aragonxpd154/PFC-circuit/docs/images/psh-card1-3d-top.png

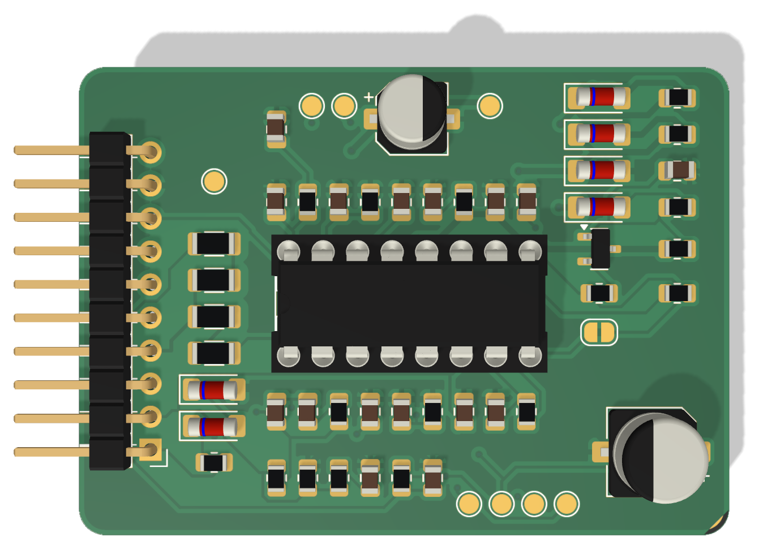
docs/images/psh-card1-3d-top.png
