aragonxpd154/PFC-circuit/docs/images/psh-jig1-bottom.png

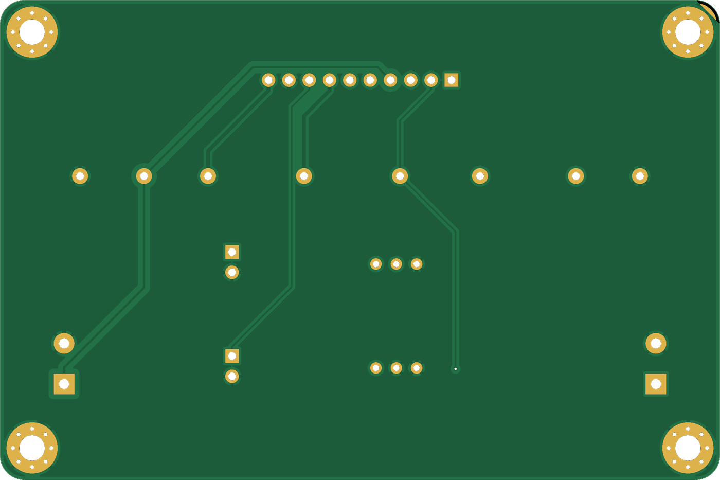
docs/images/psh-jig1-bottom.png
