aragonxpd154/PFC-circuit/docs/images/psh-jig1-layers.png

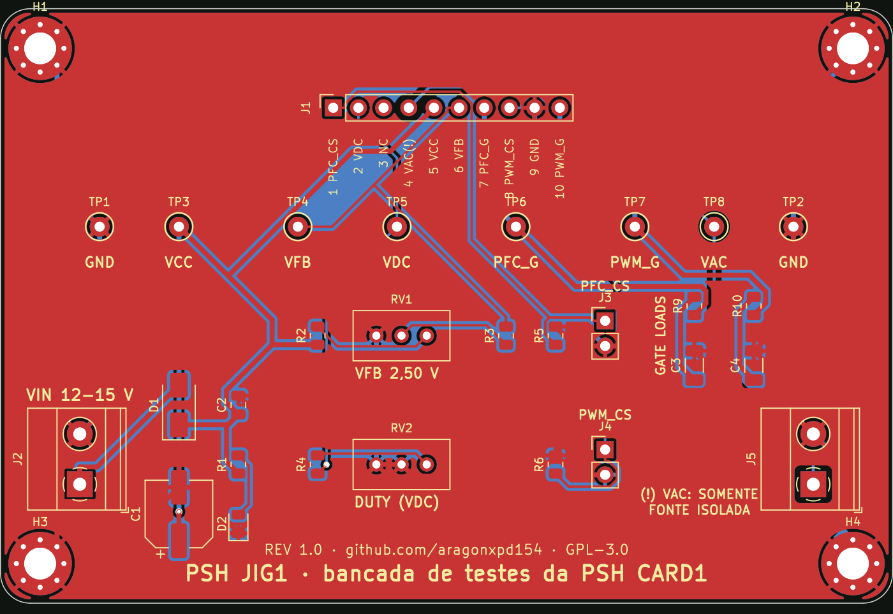
docs/images/psh-jig1-layers.png
