aragonxpd154/PFC-circuit/docs/images/psh-jig1-schematic.png

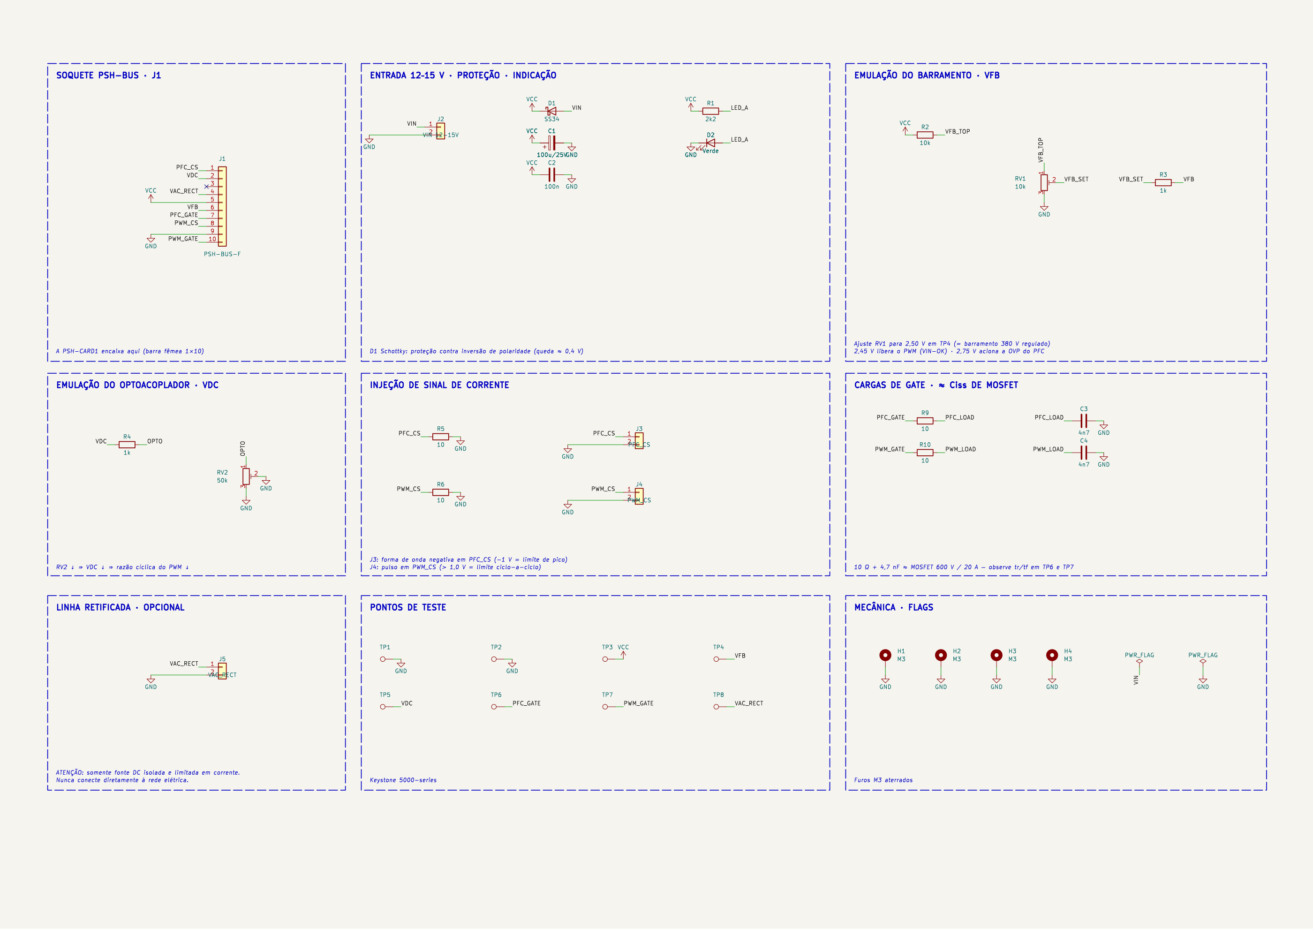
docs/images/psh-jig1-schematic.png
