aragonxpd154/PFC-circuit/mainboard1.jpg

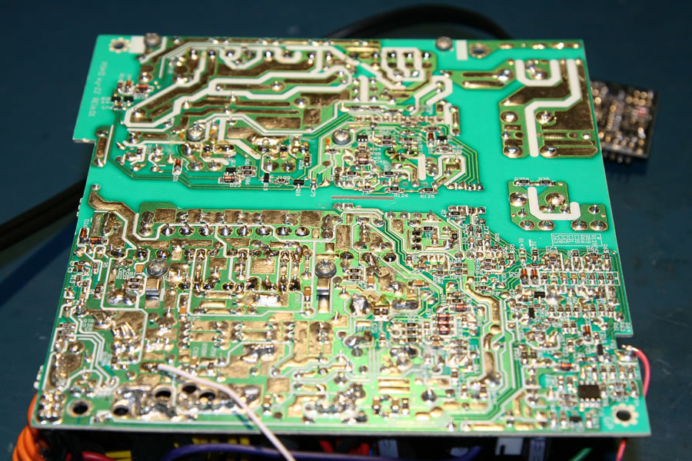
mainboard1.jpg
