aragonxpd154/PFC-circuit/hardware/psh-jig1/fab/psh-jig1-bom.csv

Item | Qtd | Referências | Valor | Footprint | Descrição | MPN | Nota
1 | 1 | D1 | SS34 | D_SMA | Schottky 3 A 40 V — proteção contra inversão | LL4148
2 | 1 | D2 | Verde | LED_0805_2012Metric | LED indicador de alimentação
3 | 4 | R5 R6 R9 R10 | 10 | R_0805_2012Metric | Resistor SMD 0805 1 %
4 | 1 | R2 | 10k | R_0805_2012Metric | Resistor SMD 0805 1 %
5 | 2 | R3 R4 | 1k | R_0805_2012Metric | Resistor SMD 0805 1 %
6 | 1 | R1 | 2k2 | R_0805_2012Metric | Resistor SMD 0805 1 %
7 | 1 | RV1 | 10k | Potentiometer_Bourns_3296W_Vertical | Trimpot multivoltas — ajuste de VFB (2,50 V nominal)
8 | 1 | RV2 | 50k | Potentiometer_Bourns_3296W_Vertical | Trimpot como reostato — emula o transistor do opto
9 | 1 | C2 | 100n | C_0805_2012Metric | Capacitor cerâmico SMD 0805 X7R
10 | 2 | C3 C4 | 4n7 | C_1206_3216Metric | Capacitor cerâmico SMD 1206 X7R
11 | 1 | C1 | 100u/25V | CP_Elec_6.3x7.7 | Capacitor eletrolítico SMD 6.3x7.7 mm
12 | 1 | J3 | PFC_CS | PinHeader_1x02_P2.54mm_Vertical | Injeção de sinal em PFC_CS (gerador de funções)
13 | 1 | J4 | PWM_CS | PinHeader_1x02_P2.54mm_Vertical | Injeção de pulso em PWM_CS (teste do limite de 1 V)
14 | 1 | J5 | VAC_RECT | TerminalBlock_Phoenix_MKDS-1,5-2-5.08_1x02_P5.08mm_Horizontal | Borne VAC_RECT — SOMENTE fonte DC isolada e limitada
15 | 1 | J2 | VIN 12-15V | TerminalBlock_Phoenix_MKDS-1,5-2-5.08_1x02_P5.08mm_Horizontal | Borne 2 vias 5,08 mm — alimentação de bancada
16 | 1 | J1 | PSH-BUS-F | PinSocket_1x10_P2.54mm_Vertical | Barra fêmea 1×10, 2,54 mm — recebe a PSH-CARD1
17 | 8 | TP1 TP2 TP3 TP4 TP5 TP6 TP7 TP8 | — | TestPoint_Keystone_5000-5004_Miniature | Ponto de teste Keystone 5000-series (gancho de ponta de prova)
18 | 4 | H1 H2 H3 H4 | — | MountingHole_3.2mm_M3_Pad_Via | Furo de fixação M3 aterrado
