aragonxpd154/PFC-circuit/hardware/psh-jig1/fab/psh-jig1-parts.csv

Referência | Valor | Footprint | Função | Redes (pino:rede) | Nota
C1 | 100u/25V | CP_Elec_6.3x7.7 | Reservatório de entrada | 1:VCC 2:GND
C2 | 100n | C_0805_2012Metric | Desacoplamento | 1:VCC 2:GND
C3 | 4n7 | C_1206_3216Metric | Ciss emulada (PFC) | 1:PFC_LOAD 2:GND
C4 | 4n7 | C_1206_3216Metric | Ciss emulada (PWM) | 1:PWM_LOAD 2:GND
D1 | SS34 | D_SMA | Schottky 3 A 40 V — proteção contra inversão | 1:VCC 2:VIN
D2 | Verde | LED_0805_2012Metric | LED indicador de alimentação | 1:GND 2:LED_A
H1 | M3 | MountingHole_3.2mm_M3_Pad_Via | Furo de fixação M3 aterrado | 1:GND
H2 | M3 | MountingHole_3.2mm_M3_Pad_Via | Furo de fixação M3 aterrado | 1:GND
H3 | M3 | MountingHole_3.2mm_M3_Pad_Via | Furo de fixação M3 aterrado | 1:GND
H4 | M3 | MountingHole_3.2mm_M3_Pad_Via | Furo de fixação M3 aterrado | 1:GND
J1 | PSH-BUS-F | PinSocket_1x10_P2.54mm_Vertical | Barra fêmea 1×10, 2,54 mm — recebe a PSH-CARD1 | 1:PFC_CS 2:VDC 3:NC 4:VAC_RECT 5:VCC 6:VFB 7:PFC_GATE 8:PWM_CS 9:GND 10:PWM_GATE
J2 | VIN 12-15V | TerminalBlock_Phoenix_MKDS-1,5-2-5.08_1x02_P5.08mm_Horizontal | Borne 2 vias 5,08 mm — alimentação de bancada | 1:VIN 2:GND
J3 | PFC_CS | PinHeader_1x02_P2.54mm_Vertical | Injeção de sinal em PFC_CS (gerador de funções) | 1:PFC_CS 2:GND
J4 | PWM_CS | PinHeader_1x02_P2.54mm_Vertical | Injeção de pulso em PWM_CS (teste do limite de 1 V) | 1:PWM_CS 2:GND
J5 | VAC_RECT | TerminalBlock_Phoenix_MKDS-1,5-2-5.08_1x02_P5.08mm_Horizontal | Borne VAC_RECT — SOMENTE fonte DC isolada e limitada | 1:VAC_RECT 2:GND
R1 | 2k2 | R_0805_2012Metric | Limitador do LED | 1:VCC 2:LED_A
R2 | 10k | R_0805_2012Metric | Topo do divisor de VFB | 1:VCC 2:VFB_TOP
R3 | 1k | R_0805_2012Metric | Série para VFB | 1:VFB_SET 2:VFB
R4 | 1k | R_0805_2012Metric | Série do emulador de opto | 1:VDC 2:OPTO
R5 | 10 | R_0805_2012Metric | Terminação de PFC_CS (0 V sem gerador) | 1:PFC_CS 2:GND
R6 | 10 | R_0805_2012Metric | Terminação de PWM_CS | 1:PWM_CS 2:GND
R9 | 10 | R_0805_2012Metric | Rg interna emulada | 1:PFC_GATE 2:PFC_LOAD
R10 | 10 | R_0805_2012Metric | Rg interna emulada | 1:PWM_GATE 2:PWM_LOAD
RV1 | 10k | Potentiometer_Bourns_3296W_Vertical | Trimpot multivoltas — ajuste de VFB (2,50 V nominal) | 1:VFB_TOP 2:VFB_SET 3:GND
RV2 | 50k | Potentiometer_Bourns_3296W_Vertical | Trimpot como reostato — emula o transistor do opto | 1:OPTO 2:GND 3:GND
TP1 | GND | TestPoint_Keystone_5000-5004_Miniature | Ponto de teste Keystone 5000-series (gancho de ponta de prova) | 1:GND
TP2 | GND | TestPoint_Keystone_5000-5004_Miniature | Ponto de teste Keystone 5000-series (gancho de ponta de prova) | 1:GND
TP3 | VCC | TestPoint_Keystone_5000-5004_Miniature | Ponto de teste Keystone 5000-series (gancho de ponta de prova) | 1:VCC
TP4 | VFB | TestPoint_Keystone_5000-5004_Miniature | Ponto de teste Keystone 5000-series (gancho de ponta de prova) | 1:VFB
TP5 | VDC | TestPoint_Keystone_5000-5004_Miniature | Ponto de teste Keystone 5000-series (gancho de ponta de prova) | 1:VDC
TP6 | PFC_GATE | TestPoint_Keystone_5000-5004_Miniature | Ponto de teste Keystone 5000-series (gancho de ponta de prova) | 1:PFC_GATE
TP7 | PWM_GATE | TestPoint_Keystone_5000-5004_Miniature | Ponto de teste Keystone 5000-series (gancho de ponta de prova) | 1:PWM_GATE
TP8 | VAC_RECT | TestPoint_Keystone_5000-5004_Miniature | Ponto de teste Keystone 5000-series (gancho de ponta de prova) | 1:VAC_RECT
