aragonxpd154/PFC-circuit/docs/3d/psh-jig1.stl

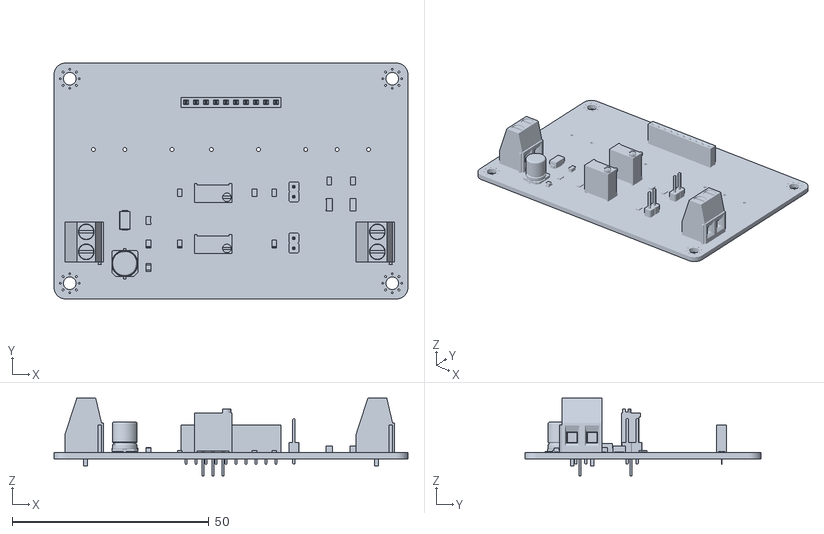
[picture p22: CAD file, 2026-11-02]
docs/3d/psh-jig1.stl
90.0 x 60.0 x 19.8
