aragonxpd154/PFC-circuit/hardware/psh-card1/fab/psh-card1.step

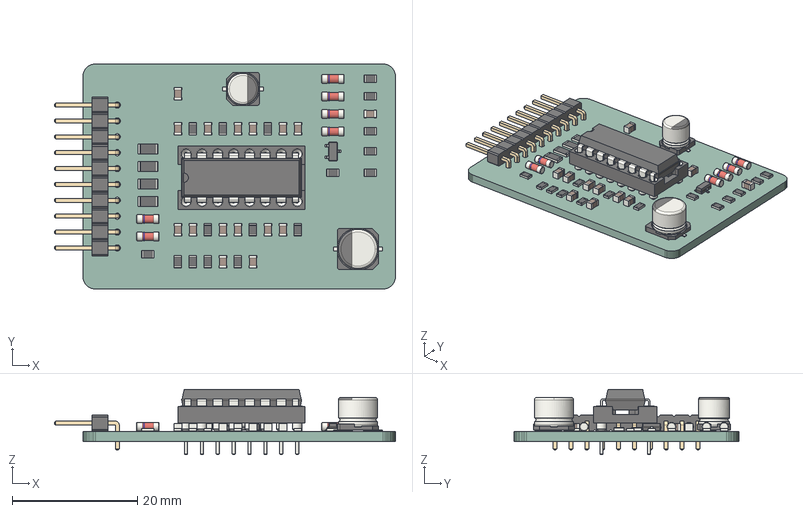
[picture p23: CAD file, 2026-11-02]
hardware/psh-card1/fab/psh-card1.step
54.5 x 36.0 x 10.5 mm
D_MiniMELF_Standard x 6
R_0805_2012Metric x 17
C_0805_2012Metric x 16
CP_Elec_5x54
R_1206_3216Metric x 4
SOT_23
CP_Elec_63x54
PinHeader_1x10_P254mm_Horizontal
DIP_16_W762mm_Socket
DIP-16_W7.62mm
psh-card1 PCB
