aragonxpd154/PFC-circuit/(list of files, cad)

Other CAD files:
hardware/psh-jig1/fab/psh-jig1.step
docs/3d/psh-card1.stl
