aragonxpd154/PFC-circuit/hardware/psh-card1/fab/psh-card1-assembly.pdf

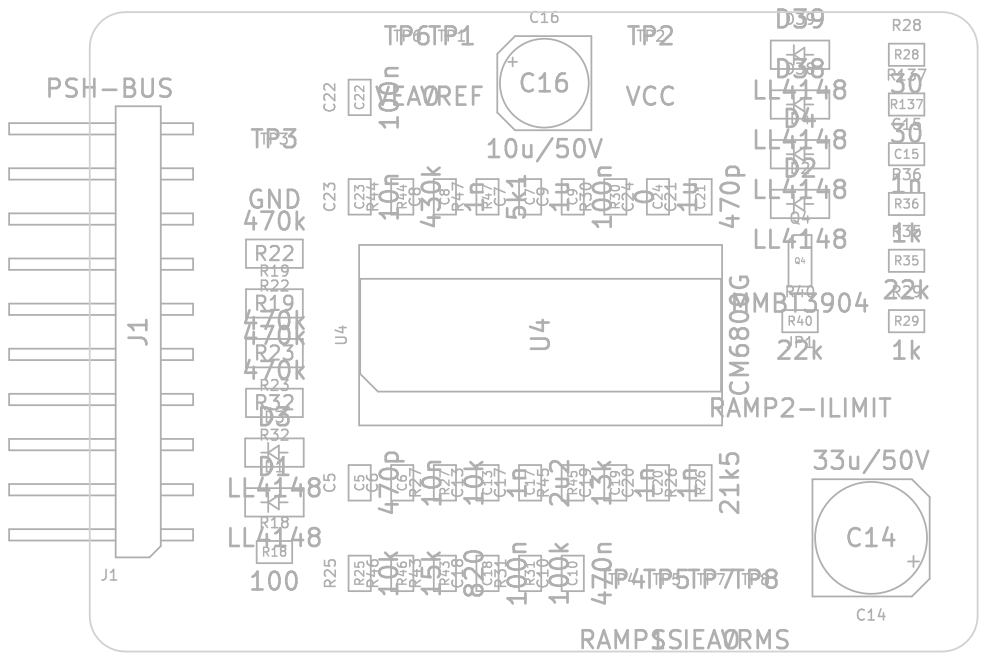
[picture p24: page 1]

Id: 1/1 Title: File: psh-card1.kicad_pcb Sheet:
