aragonxpd154/PFC-circuit/hardware/psh-jig1/fab/psh-jig1-assembly.pdf

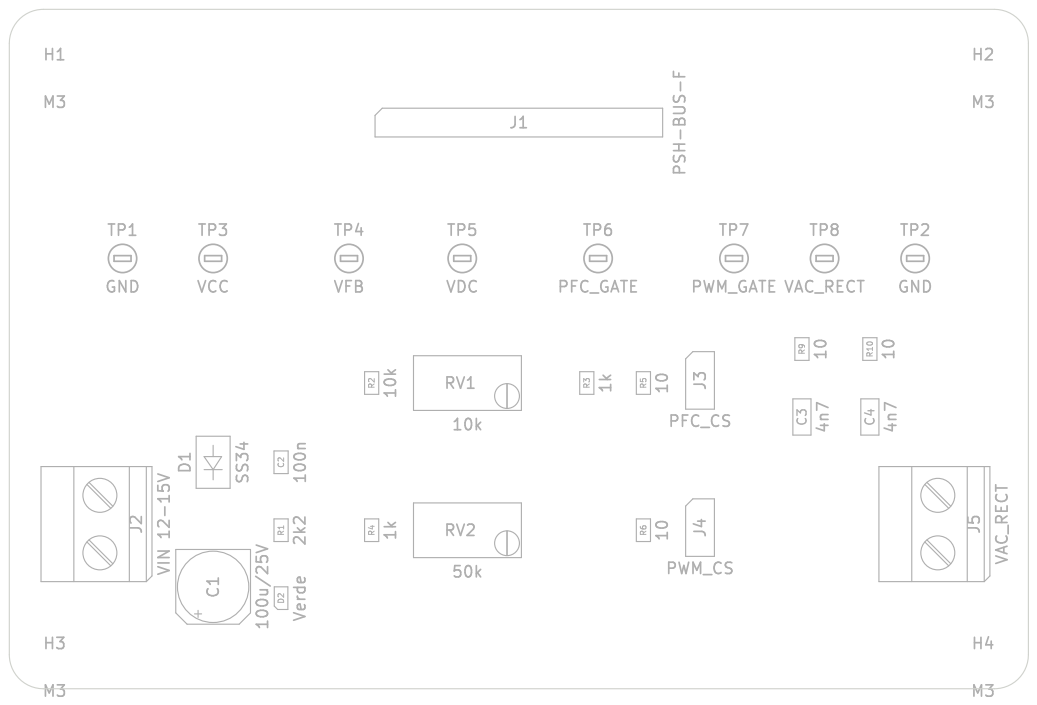
[picture p25: page 1]

Id: 1/1 Title: File: psh-jig1.kicad_pcb Sheet: GND
