aragonxpd154/PFC-circuit/hardware/psh-jig1/fab/psh-jig1-schematic.pdf

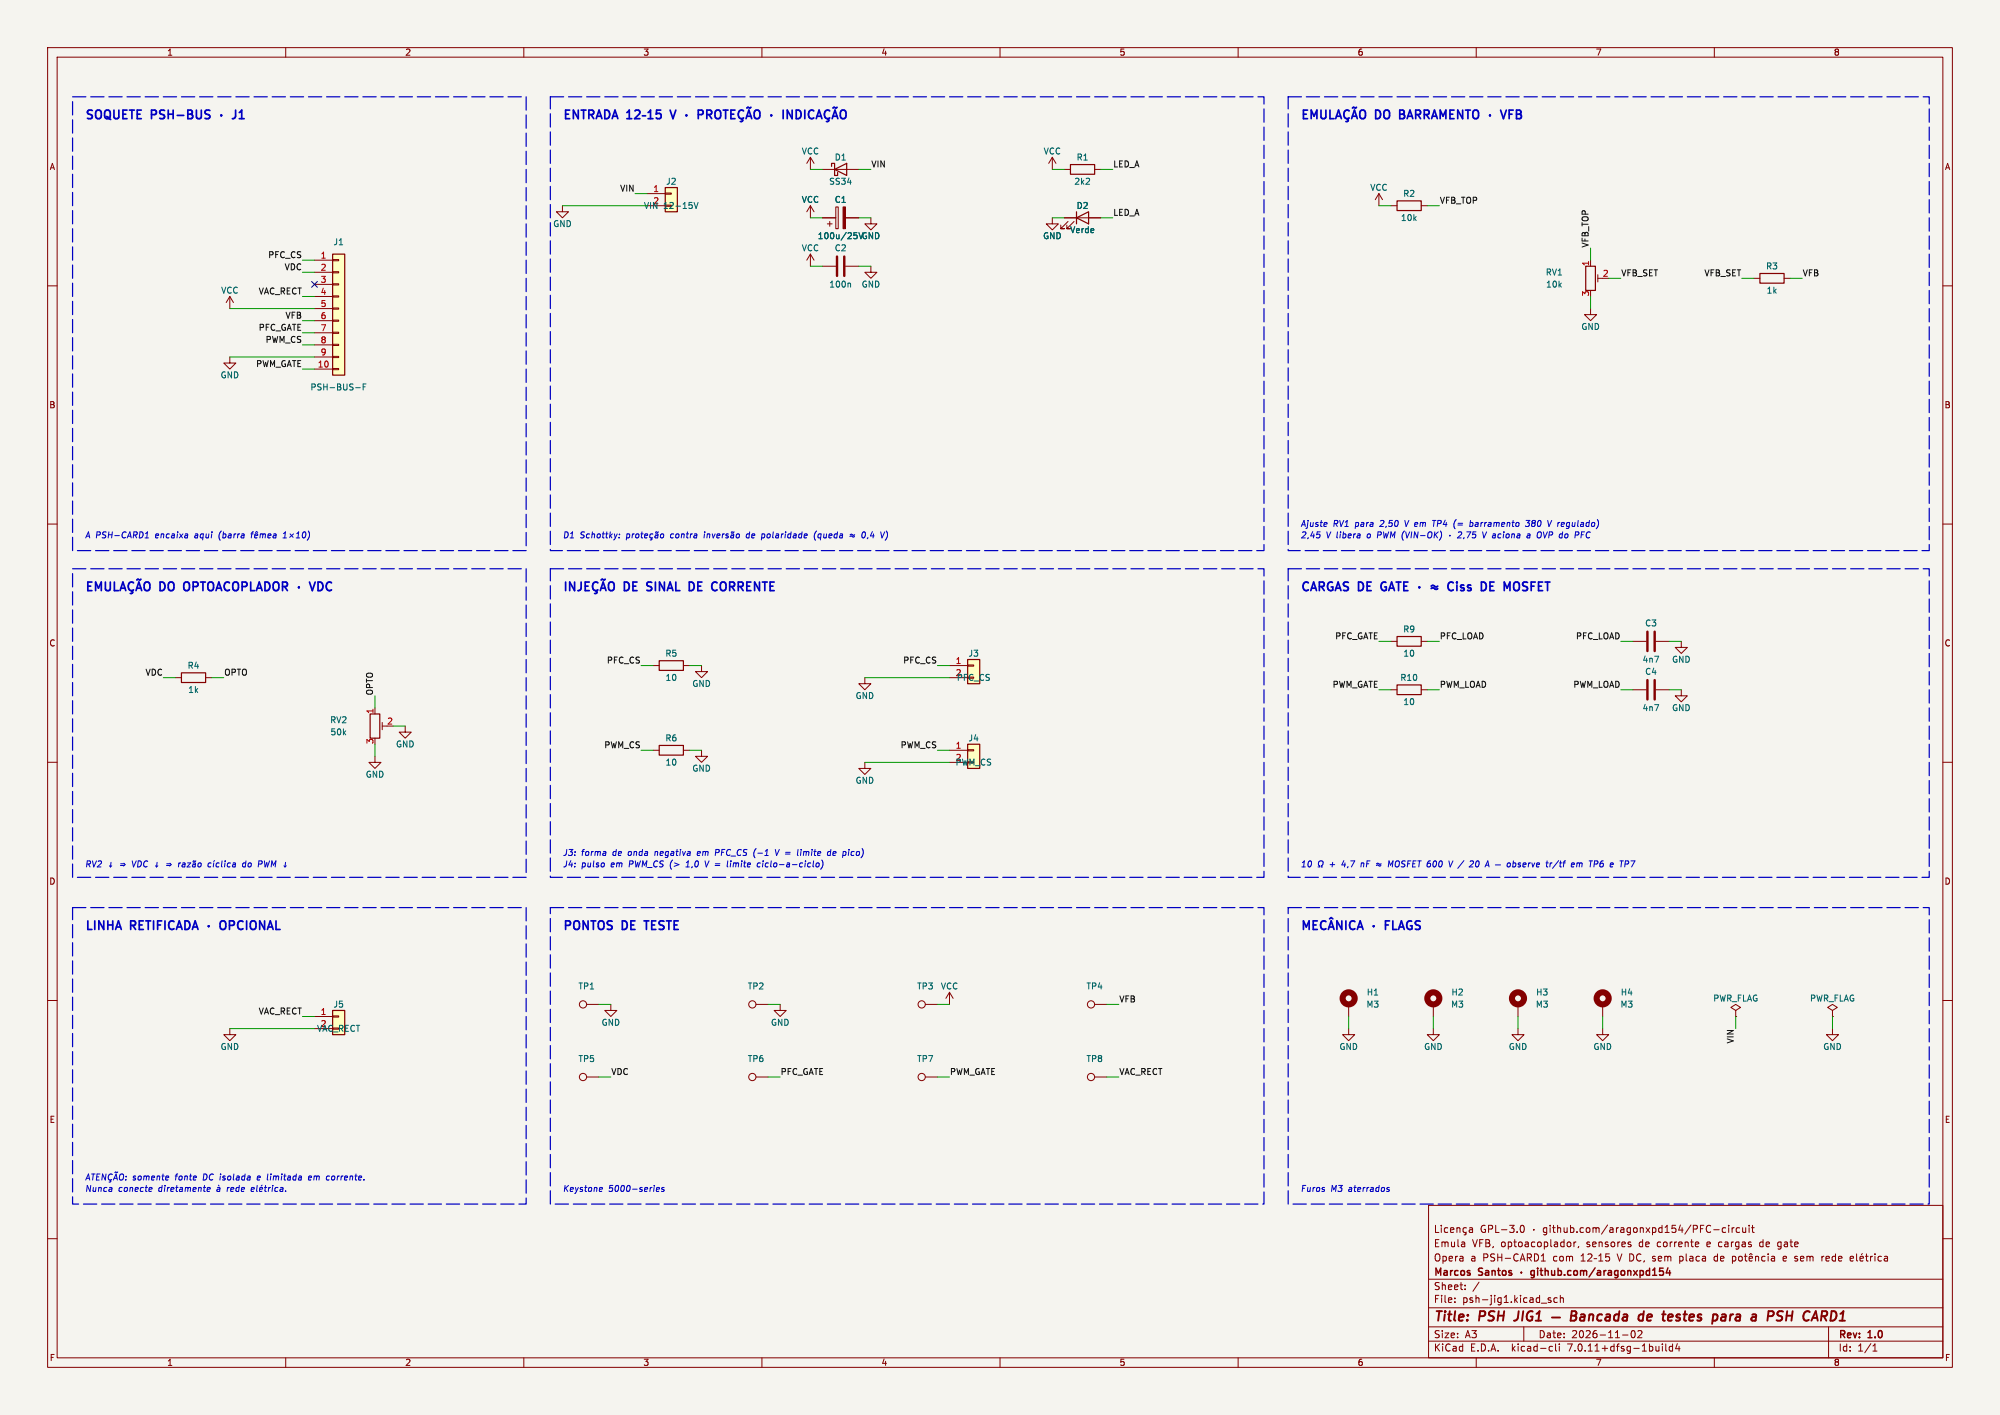
[picture p26: page 1]

ENTRADA þÿ12 15V þÿ·þÿPROTEÇÃO þÿ·þÿINDICAÇÃO

þÿEMULAÇÃO DO BARRAMENTO þÿ·VFB

þÿEMULAÇÃO DO OPTOACOPLADOR þÿ·VDC

þÿINJEÇÃO DE SINAL DE CORRENTE
PWM_CS

CARGAS DE GATE þÿ·þÿ"HCiss DE MOSFET

RV2 þÿ!“þÿ!ÒVDC þÿ!“þÿ!Òþÿrazão þÿcíclica do PWM þÿ!“

Id: 1/1 Title: PSH JIG1 þÿ Bancada de testes para a PSH CARD1
