aragonxpd154/PFC-circuit/hardware/psh-jig1/psh-jig1.kicad_pcb

## KiCad design hardware/psh-jig1/psh-jig1.kicad_pcb (2026-11-02)

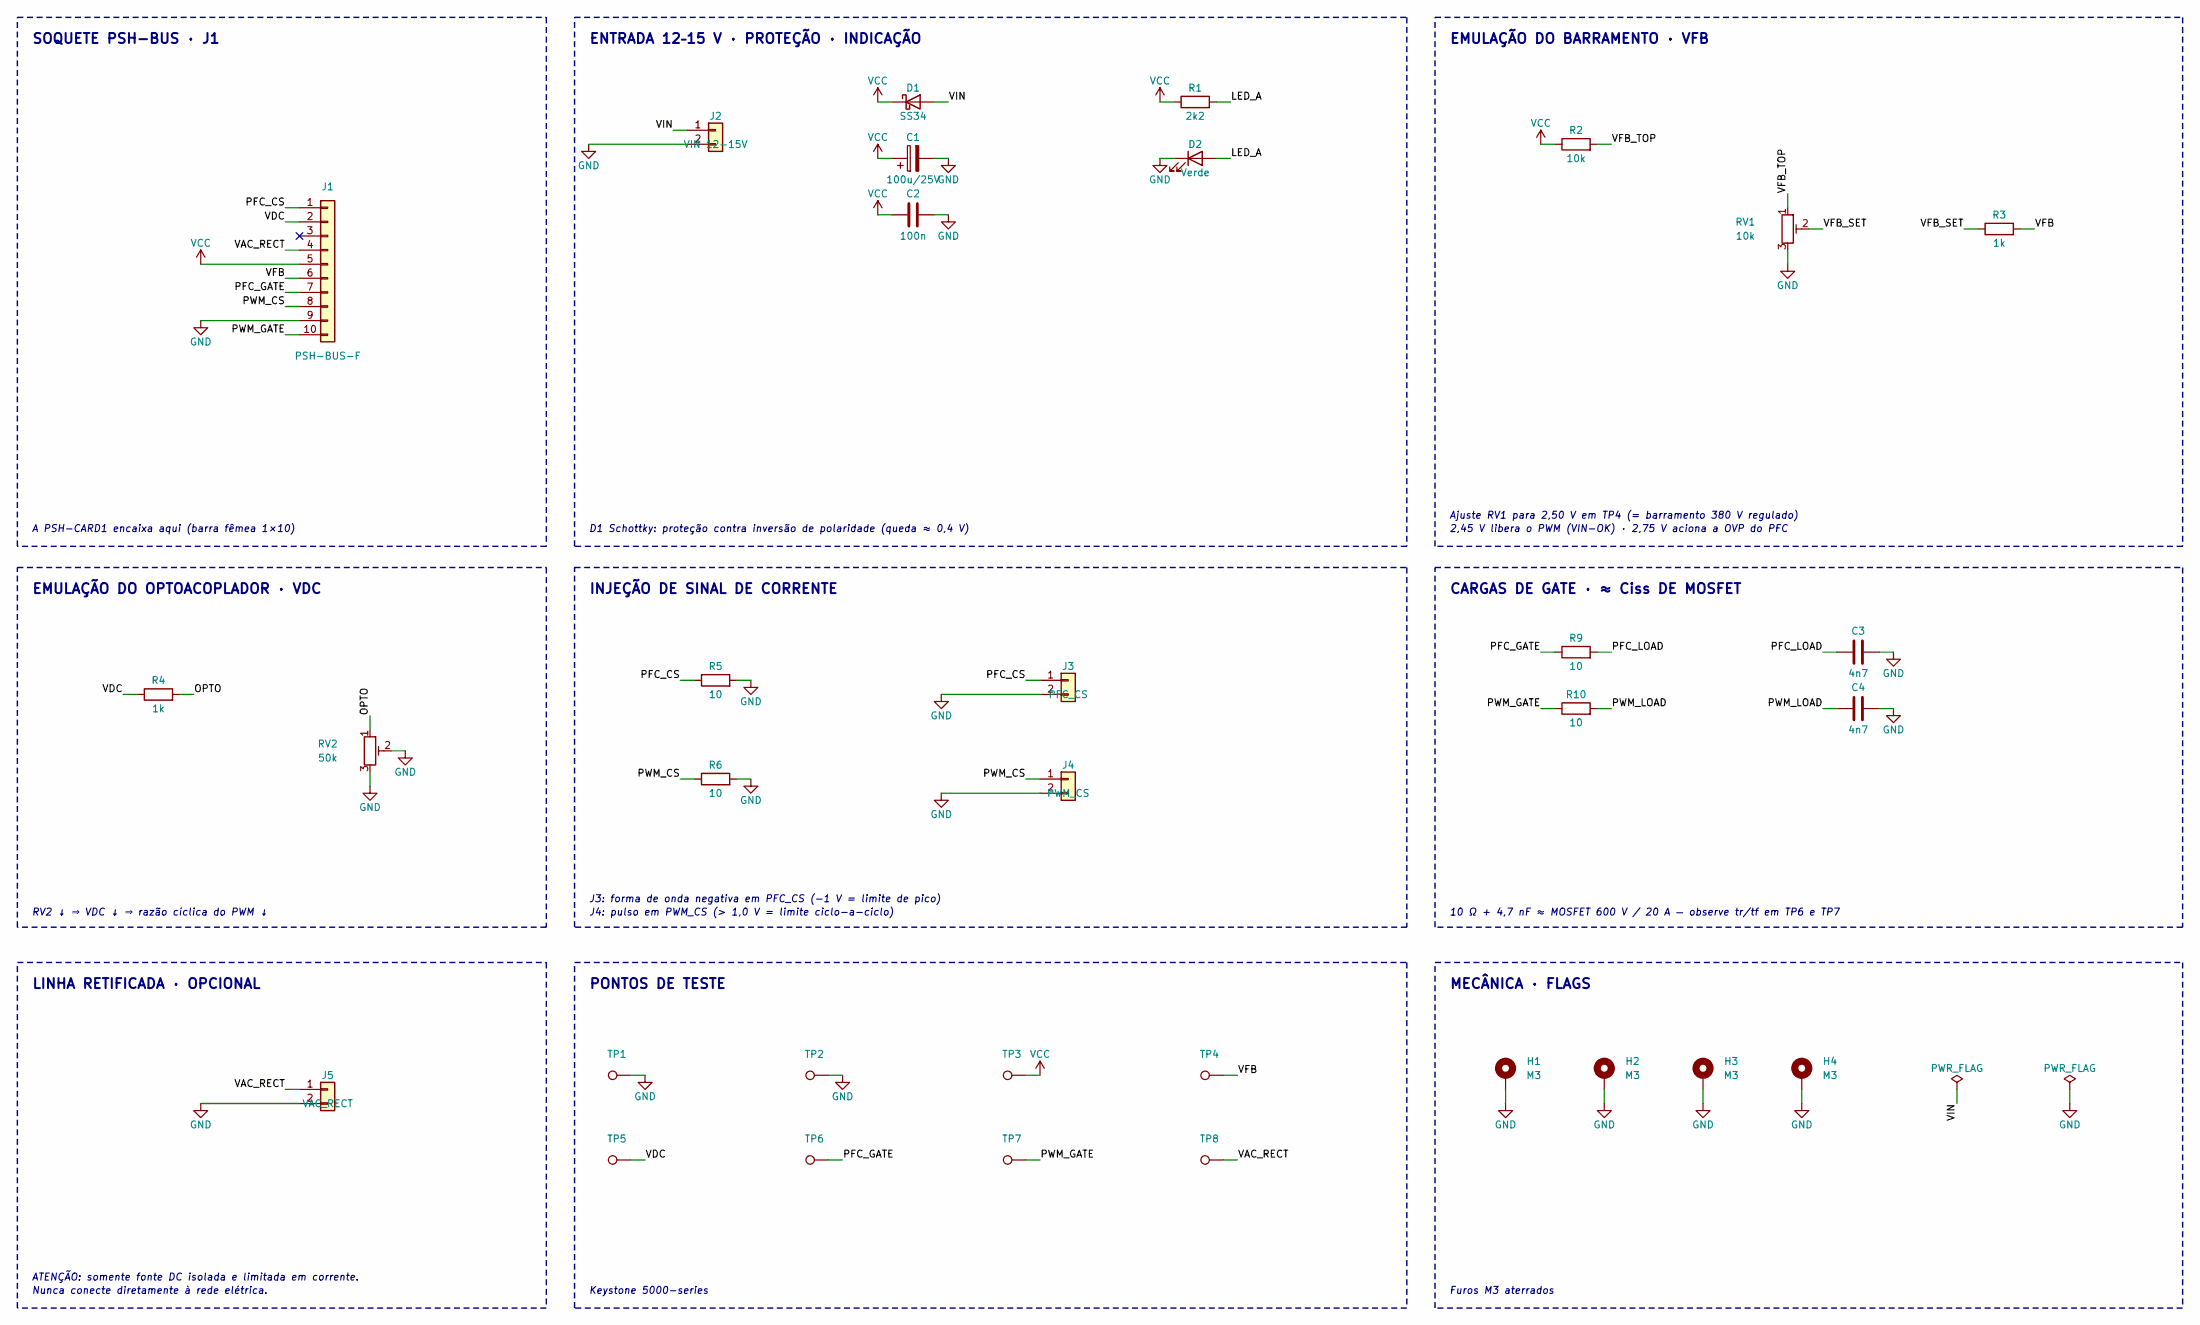
[picture p27: schematic psh-jig1.kicad_sch, PSH JIG1 — Bancada de testes para a PSH CARD1]

Parts:
C1: 100u/25V; CP_Elec_6.3x7.7
C2: 100n; C_0805_2012Metric
C3, C4: 4n7; C_1206_3216Metric
D1: SS34; D_SMA; MPN LL4148
D2: Verde; LED_0805_2012Metric
H1, H2, H3, H4: M3; MountingHole_3.2mm_M3_Pad_Via
J1: PSH-BUS-F; PinSocket_1x10_P2.54mm_Vertical
J2: VIN 12-15V; TerminalBlock_Phoenix_MKDS-1,5-2-5.08_1x02_P5.08mm_Horizont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
J3: PFC_CS; PinHeader_1x02_P2.54mm_Vertical
J4: PWM_CS; PinHeader_1x02_P2.54mm_Vertical
J5: VAC_RECT; TerminalBlock_Phoenix_MKDS-1,5-2-5.08_1x02_P5.08mm_Horizont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
R1: 2k2; R_0805_2012Metric
R2: 10k; R_0805_2012Metric
R3, R4: 1k; R_0805_2012Metric
R5, R6, R9, R10: 10; R_0805_2012Metric
RV1: 10k; Potentiometer_Bourns_3296W_Vertical
RV2: 50k; Potentiometer_Bourns_3296W_Vertical
TP1, TP2: GND; TestPoint_Keystone_5000-5004_Miniature
TP3: VCC; TestPoint_Keystone_5000-5004_Miniature
TP4: VFB; TestPoint_Keystone_5000-5004_Miniature
TP5: VDC; TestPoint_Keystone_5000-5004_Miniature
TP6: PFC_GATE; TestPoint_Keystone_5000-5004_Miniature
TP7: PWM_GATE; TestPoint_Keystone_5000-5004_Miniature
TP8: VAC_RECT; TestPoint_Keystone_5000-5004_Miniature

Connections:
GND: C1.2, C2.2, C3.2, C4.2, D2.1 (K), H1.1, H2.1, H3.1, H4.1, J1.9, J2.2, J3.2, J4.2, J5.2, R5.2, R6.2, RV1.3, RV2.2, RV2.3, TP1.1, TP2.1
LED_A: D2.2 (A), R1.2
OPTO: R4.2, RV2.1
PFC_CS: J1.1, J3.1, R5.1
PFC_GATE: J1.7, R9.1, TP6.1
PFC_LOAD: C3.1, R9.2
PWM_CS: J1.8, J4.1, R6.1
PWM_GATE: J1.10, R10.1, TP7.1
PWM_LOAD: C4.1, R10.2
VAC_RECT: J1.4, J5.1, TP8.1
VCC: C1.1, C2.1, D1.1 (K), J1.5, R1.1, R2.1, TP3.1
VDC: J1.2, R4.1, TP5.1
VFB: J1.6, R3.2, TP4.1
VFB_SET: R3.1, RV1.2
VFB_TOP: R2.2, RV1.1
VIN: D1.2 (A), J2.1

Notes on the sheet:
SOQUETE PSH-BUS · J1
A PSH-CARD1 encaixa aqui (barra fêmea 1×10)
ENTRADA 12–15 V · PROTEÇÃO · INDICAÇÃO
D1 Schottky: proteção contra inversão de polaridade (queda ≈ 0,4 V)
EMULAÇÃO DO BARRAMENTO · VFB
Ajuste RV1 para 2,50 V em TP4 (= barramento 380 V regulado)
2,45 V libera o PWM (VIN-OK) · 2,75 V aciona a OVP do PFC
EMULAÇÃO DO OPTOACOPLADOR · VDC
RV2 ↓ ⇒ VDC ↓ ⇒ razão cíclica do PWM ↓
INJEÇÃO DE SINAL DE CORRENTE
J3: forma de onda negativa em PFC_CS (−1 V = limite de pico)
J4: pulso em PWM_CS (> 1,0 V = limite ciclo-a-ciclo)
CARGAS DE GATE · ≈ Ciss DE MOSFET
10 Ω + 4,7 nF ≈ MOSFET 600 V / 20 A — observe tr/tf em TP6 e TP7
LINHA RETIFICADA · OPCIONAL
ATENÇÃO: somente fonte DC isolada e limitada em corrente.
Nunca conecte diretamente à rede elétrica.
PONTOS DE TESTE
Keystone 5000-series
MECÂNICA · FLAGS
Furos M3 aterrados

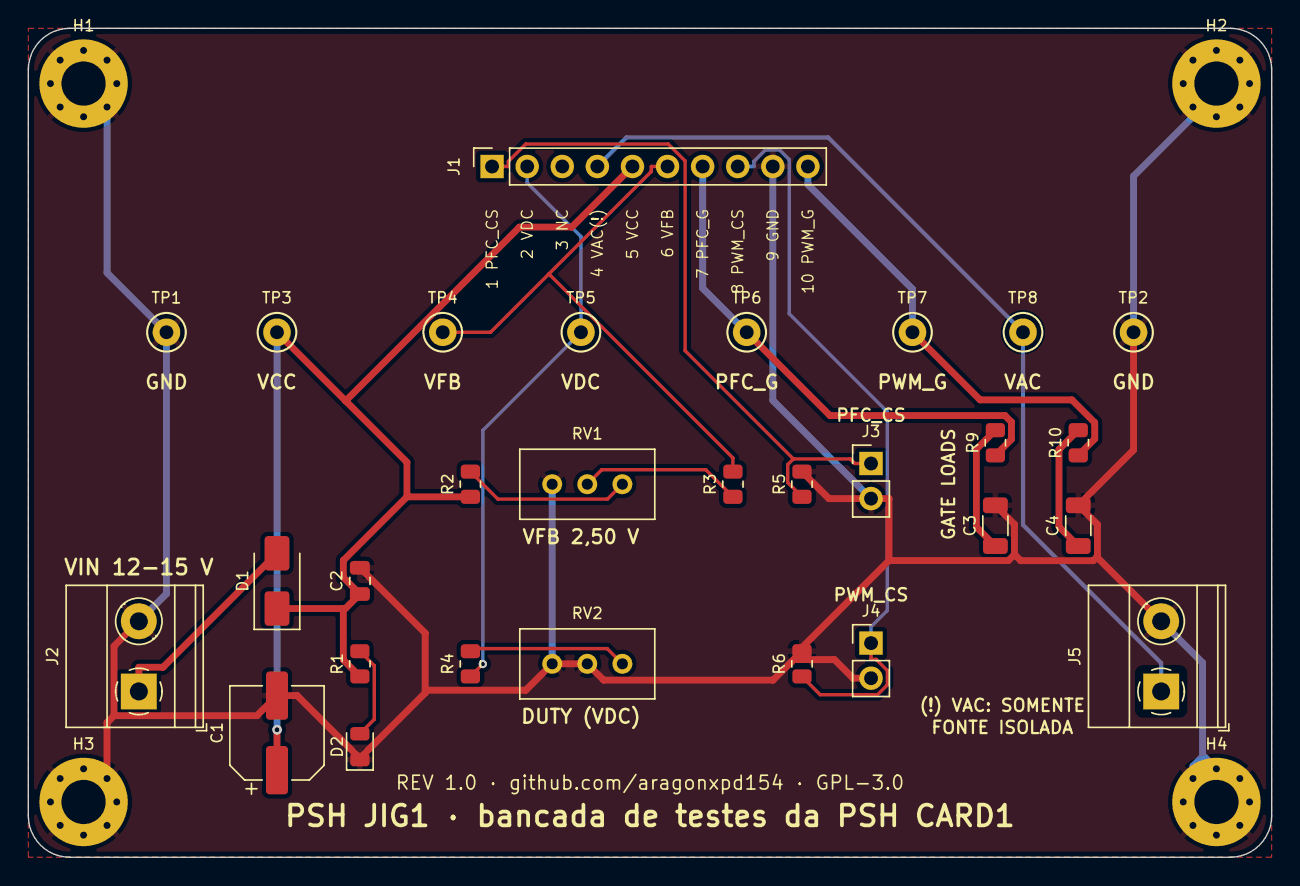
[picture p28: board psh-jig1.kicad_pcb from above]

Board: 2 copper layers, 90.0 x 60.0 mm, 33 parts (0 on the bottom side), 16 nets.
