aragonxpd154/PFC-circuit/hardware/psh-card1/psh-card1.kicad_pcb

## KiCad design hardware/psh-card1/psh-card1.kicad_pcb (2026-11-02)

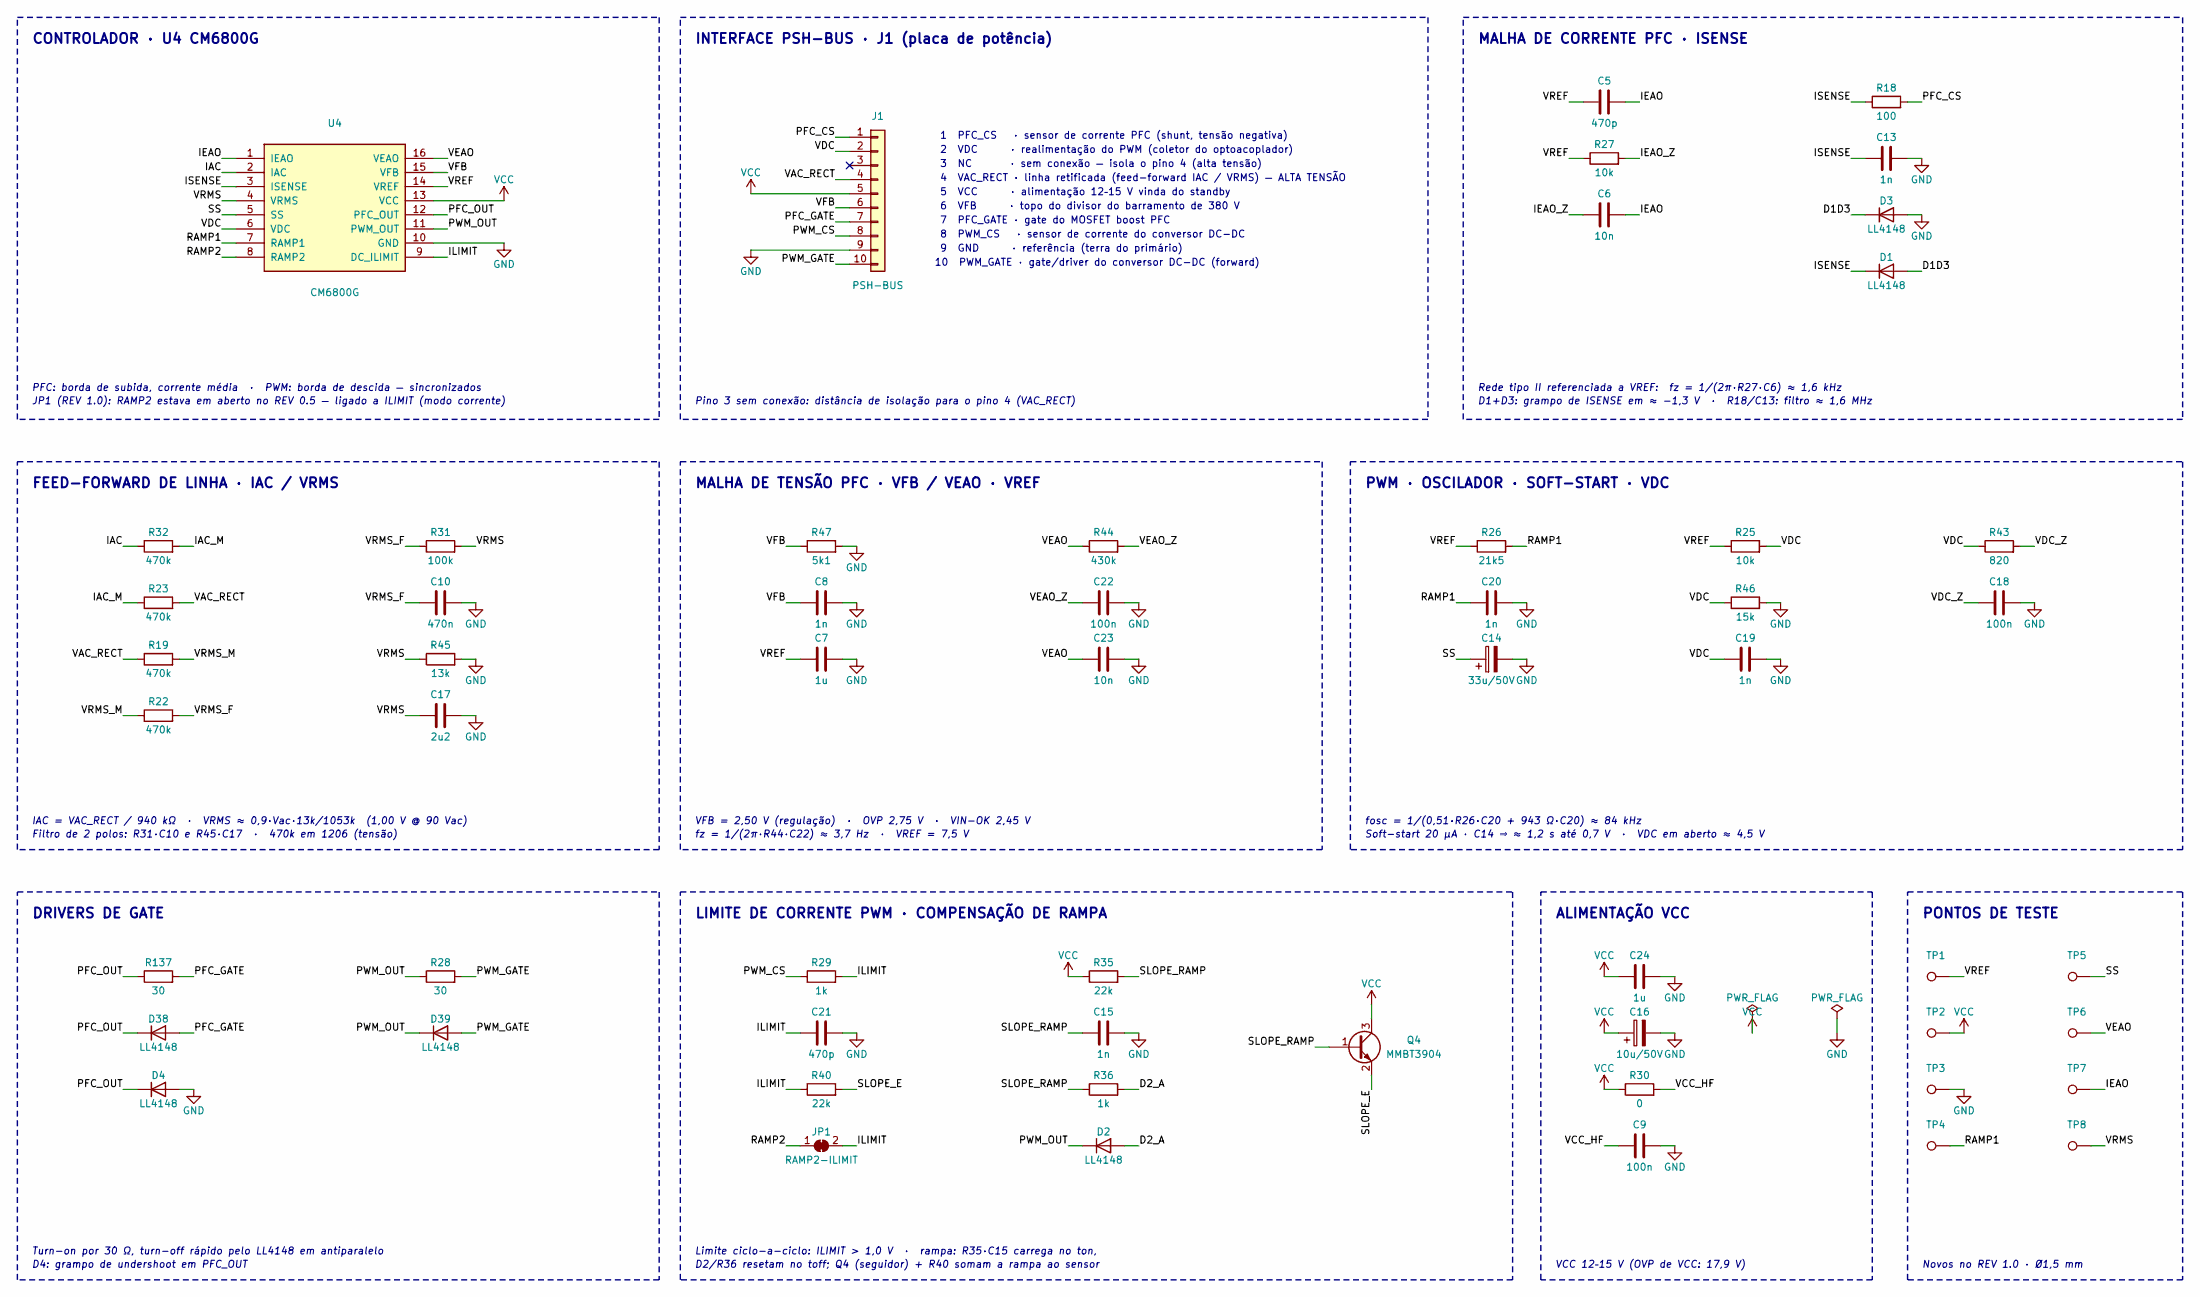
[picture p29: schematic psh-card1.kicad_sch, PSH CARD1 — Controlador PFC/PWM CM6800G]

Parts:
C5, C21: 470p; C_0805_2012Metric
C6, C23: 10n; C_0805_2012Metric
C7, C24: 1u; C_0805_2012Metric
C8, C13, C15, C19, C20: 1n; C_0805_2012Metric
C9, C18, C22: 100n; C_0805_2012Metric
C10: 470n; C_0805_2012Metric
C14: 33u/50V; CP_Elec_6.3x5.4
C16: 10u/50V; CP_Elec_5x5.4
C17: 2u2; C_0805_2012Metric
D1, D2, D3, D4, D38, D39: LL4148; D_MiniMELF; MPN LL4148
J1: PSH-BUS; PinHeader_1x10_P2.54mm_Horizontal
JP1: RAMP2-ILIMIT; SolderJumper-2_P1.3mm_Bridged_RoundedPad1.0x1.5mm
Q4: MMBT3904; SOT-23; MPN MMBT3904
R18: 100; R_0805_2012Metric
R19, R22, R23, R32: 470k; R_1206_3216Metric
R25, R27: 10k; R_0805_2012Metric
R26: 21k5; R_0805_2012Metric
R28, R137: 30; R_0805_2012Metric
R29, R36: 1k; R_0805_2012Metric
R30: 0; R_0805_2012Metric
R31: 100k; R_0805_2012Metric
R35, R40: 22k; R_0805_2012Metric
R43: 820; R_0805_2012Metric
R44: 430k; R_0805_2012Metric
R45: 13k; R_0805_2012Metric
R46: 15k; R_0805_2012Metric
R47: 5k1; R_0805_2012Metric
TP1: VREF; TestPoint_Pad_D1.5mm
TP2: VCC; TestPoint_Pad_D1.5mm
TP3: GND; TestPoint_Pad_D1.5mm
TP4: RAMP1; TestPoint_Pad_D1.5mm
TP5: SS; TestPoint_Pad_D1.5mm
TP6: VEAO; TestPoint_Pad_D1.5mm
TP7: IEAO; TestPoint_Pad_D1.5mm
TP8: VRMS; TestPoint_Pad_D1.5mm
U4: CM6800G; DIP-16_W7.62mm_Socket; MPN CM6800GIP

Connections:
D1D3: D1.2 (A), D3.1 (K)
D2_A: D2.2 (A), R36.2
GND: C7.2, C8.2, C9.2, C10.2, C13.2, C14.2, C15.2, C16.2, C17.2, C18.2, C19.2, C20.2, C21.2, C22.2, C23.2, C24.2, D3.2 (A), D4.2 (A), J1.9, R45.2, R46.2, R47.2, TP3.1, U4.10 (GND)
IAC: R32.1, U4.2 (IAC)
IAC_M: R23.1, R32.2
IEAO: C5.2, C6.2, TP7.1, U4.1 (IEAO)
IEAO_Z: C6.1, R27.2
ILIMIT: C21.1, JP1.2 (B), R29.2, R40.1, U4.9 (DC_ILIMIT)
ISENSE: C13.1, D1.1 (K), R18.1, U4.3 (ISENSE)
PFC_CS: J1.1, R18.2
PFC_GATE: D38.2 (A), J1.7, R137.2
PFC_OUT: D4.1 (K), D38.1 (K), R137.1, U4.12 (PFC_OUT)
PWM_CS: J1.8, R29.1
PWM_GATE: D39.2 (A), J1.10, R28.2
PWM_OUT: D2.1 (K), D39.1 (K), R28.1, U4.11 (PWM_OUT)
RAMP1: C20.1, R26.2, TP4.1, U4.7 (RAMP1)
RAMP2: JP1.1 (A), U4.8 (RAMP2)
SLOPE_E: Q4.2 (E), R40.2
SLOPE_RAMP: C15.1, Q4.1 (B), R35.2, R36.1
SS: C14.1, TP5.1, U4.5 (SS)
VAC_RECT: J1.4, R19.1, R23.2
VCC: C16.1, C24.1, J1.5, Q4.3 (C), R30.1, R35.1, TP2.1, U4.13 (VCC)
VCC_HF: C9.1, R30.2
VDC: C19.1, J1.2, R25.2, R43.1, R46.1, U4.6 (VDC)
VDC_Z: C18.1, R43.2
VEAO: C23.1, R44.1, TP6.1, U4.16 (VEAO)
VEAO_Z: C22.1, R44.2
VFB: C8.1, J1.6, R47.1, U4.15 (VFB)
VREF: C5.1, C7.1, R25.1, R26.1, R27.1, TP1.1, U4.14 (VREF)
VRMS: C17.1, R31.2, R45.1, TP8.1, U4.4 (VRMS)
VRMS_F: C10.1, R22.2, R31.1
VRMS_M: R19.2, R22.1

Notes on the sheet:
CONTROLADOR · U4 CM6800G
PFC: borda de subida, corrente média · PWM: borda de descida — sincronizados
JP1 (REV 1.0): RAMP2 estava em aberto no REV 0.5 — ligado a ILIMIT (modo corrente)
INTERFACE PSH-BUS · J1 (placa de potência)
Pino 3 sem conexão: distância de isolação para o pino 4 (VAC_RECT)
1 PFC_CS · sensor de corrente PFC (shunt, tensão negativa)
2 VDC · realimentação do PWM (coletor do optoacoplador)
3 NC · sem conexão — isola o pino 4 (alta tensão)
4 VAC_RECT · linha retificada (feed-forward IAC / VRMS) — ALTA TENSÃO
5 VCC · alimentação 12–15 V vinda do standby
6 VFB · topo do divisor do barramento de 380 V
7 PFC_GATE · gate do MOSFET boost PFC
8 PWM_CS · sensor de corrente do conversor DC-DC
9 GND · referência (terra do primário)
10 PWM_GATE · gate/driver do conversor DC-DC (forward)
MALHA DE CORRENTE PFC · ISENSE
Rede tipo II referenciada a VREF: fz = 1/(2π·R27·C6) ≈ 1,6 kHz
D1+D3: grampo de ISENSE em ≈ −1,3 V · R18/C13: filtro ≈ 1,6 MHz
FEED-FORWARD DE LINHA · IAC / VRMS
IAC = VAC_RECT / 940 kΩ · VRMS ≈ 0,9·Vac·13k/1053k (1,00 V @ 90 Vac)
Filtro de 2 polos: R31·C10 e R45·C17 · 470k em 1206 (tensão)
MALHA DE TENSÃO PFC · VFB / VEAO · VREF
VFB = 2,50 V (regulação) · OVP 2,75 V · VIN-OK 2,45 V
fz = 1/(2π·R44·C22) ≈ 3,7 Hz · VREF = 7,5 V
PWM · OSCILADOR · SOFT-START · VDC
fosc = 1/(0,51·R26·C20 + 943 Ω·C20) ≈ 84 kHz
Soft-start 20 µA · C14 ⇒ ≈ 1,2 s até 0,7 V · VDC em aberto ≈ 4,5 V
DRIVERS DE GATE
Turn-on por 30 Ω, turn-off rápido pelo LL4148 em antiparalelo
D4: grampo de undershoot em PFC_OUT
LIMITE DE CORRENTE PWM · COMPENSAÇÃO DE RAMPA
Limite ciclo-a-ciclo: ILIMIT > 1,0 V · rampa: R35·C15 carrega no ton,
D2/R36 resetam no toff; Q4 (seguidor) + R40 somam a rampa ao sensor
ALIMENTAÇÃO VCC
VCC 12–15 V (OVP de VCC: 17,9 V)
PONTOS DE TESTE
Novos no REV 1.0 · Ø1,5 mm

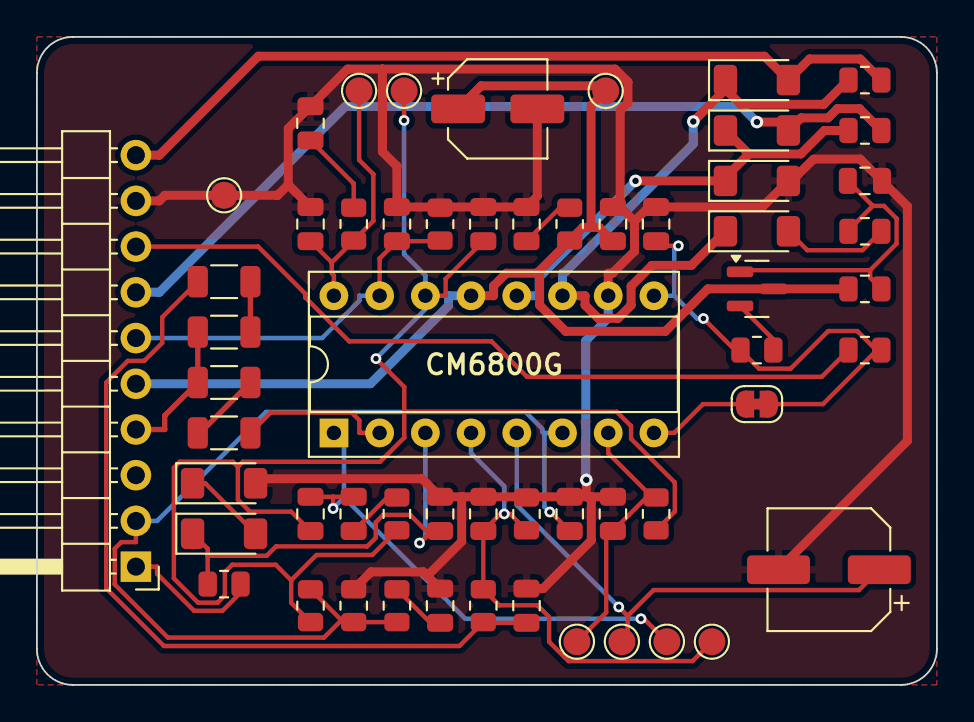
[picture p30: board psh-card1.kicad_pcb from above]

Board: 2 copper layers, 50.0 x 36.0 mm, 57 parts (0 on the bottom side), 32 nets.
