aragonxpd154/PFC-circuit/tools/eda/pcb_layouts.py

"""Posicionamento físico (mm, relativo ao canto superior esquerdo da placa).

(x, y, rotação°)   — rotação 90 nos 0805/1206 = componente "em pé" (vertical).
Todos os SMD ficam na face superior (montagem manual em uma só face).
"""

# =============================================================================
#  PSH-CARD1 — 50 × 36 mm, 2 camadas, 1,6 mm
# =============================================================================
CARD_SIZE = (50.0, 36.0)
V, H = 90, 0

CARD_POS = {
    # Conector (pinos em ângulo reto saindo pela borda esquerda) e CI
    "J1": (5.5, 29.43, 180),
    "U4": (16.5, 22.0, 90),           # pino 1 embaixo à esquerda

    # Faixa superior — malha de tensão, referência, VCC
    "C23": (15.2, 10.4, V), "R44": (17.6, 10.4, V), "C8": (20.0, 10.4, V),
    "R47": (22.4, 10.4, V), "C7": (24.8, 10.4, V), "C9": (27.2, 10.4, V),
    "R30": (29.6, 10.4, V), "C24": (32.0, 10.4, V), "C21": (34.4, 10.4, V),
    "C22": (15.2, 4.8, V), "TP6": (17.9, 3.0, 0), "TP1": (20.4, 3.0, 0),
    "C16": (25.6, 4.0, 0), "TP2": (31.6, 3.0, 0),

    # Coluna direita — drivers de gate e compensação de rampa
    "D39": (40.0, 2.4, H), "R28": (46.0, 2.4, H),
    "D38": (40.0, 5.2, H), "R137": (46.0, 5.2, H),
    "D4": (40.0, 8.0, H), "C15": (46.0, 8.0, H),
    "D2": (40.0, 10.8, H), "R36": (46.0, 10.8, H),
    "Q4": (40.0, 14.0, 0), "R35": (46.0, 14.0, H),
    "R40": (40.0, 17.4, H), "R29": (46.0, 17.4, H),
    "JP1": (40.0, 20.4, 0),
    "C14": (44.0, 29.6, 180),

    # Faixa inferior — malha de corrente, oscilador, soft-start, VDC
    "C5": (15.2, 26.5, V), "C6": (17.6, 26.5, V), "R27": (20.0, 26.5, V),
    "C13": (22.4, 26.5, V), "C17": (24.8, 26.5, V), "R45": (27.2, 26.5, V),
    "C19": (29.6, 26.5, V), "C20": (32.0, 26.5, V), "R26": (34.4, 26.5, V),
    "R25": (15.2, 31.6, V), "R46": (17.6, 31.6, V), "R43": (20.0, 31.6, V),
    "C18": (22.4, 31.6, V), "R31": (24.8, 31.6, V), "C10": (27.2, 31.6, V),
    "TP4": (30.0, 33.6, 0), "TP5": (32.5, 33.6, 0), "TP7": (35.0, 33.6, 0), "TP8": (37.5, 33.6, 0),

    # Coluna esquerda — cadeia de alta tensão (IAC / VRMS) e sensor ISENSE
    # pads de VAC_RECT voltados para J1.4 (trilhas de AT curtas e isoladas)
    "R22": (10.4, 13.6, 180), "R19": (10.4, 16.4, H),
    "R23": (10.4, 19.2, 180), "R32": (10.4, 22.0, 180),
    "D3": (10.4, 24.8, H), "D1": (10.4, 27.6, H), "R18": (10.4, 30.4, H),
    "TP3": (10.4, 8.8, 0),
}

# =============================================================================
#  PSH-JIG1 — 90 × 60 mm, 2 camadas
# =============================================================================
JIG_SIZE = (90.0, 60.0)

JIG_POS = {
    "J1": (33.57, 10.0, 90),           # soquete horizontal no topo (pino 1 à esquerda)
    "J2": (8.0, 48.0, 90), "D1": (18.0, 40.0, 90), "C1": (18.0, 51.0, 90),
    "C2": (24.0, 40.0, V), "R1": (24.0, 46.0, V), "D2": (24.0, 52.0, V),
    "R2": (32.0, 33.0, V), "RV1": (43.0, 33.0, 0), "R3": (51.0, 33.0, V),
    "R4": (32.0, 46.0, V), "RV2": (43.0, 46.0, 0),
    "R5": (56.0, 33.0, V), "J3": (61.0, 31.5, 0),
    "R6": (56.0, 46.0, V), "J4": (61.0, 44.5, 0),
    "R9": (70.0, 30.0, V), "C3": (70.0, 36.0, V),
    "R10": (76.0, 30.0, V), "C4": (76.0, 36.0, V),
    "J5": (82.0, 48.0, 90),
    "TP1": (10.0, 22.0, 0), "TP2": (80.0, 22.0, 0), "TP3": (18.0, 22.0, 0),
    "TP4": (30.0, 22.0, 0), "TP5": (40.0, 22.0, 0), "TP6": (52.0, 22.0, 0),
    "TP7": (64.0, 22.0, 0), "TP8": (72.0, 22.0, 0),
    "H1": (4.0, 4.0, 0), "H2": (86.0, 4.0, 0), "H3": (4.0, 56.0, 0), "H4": (86.0, 56.0, 0),
}
