aragonxpd154/PFC-circuit/(notices)

Notices in the files:
hardware/psh-card1/psh-card1.kicad_pcb:
GPL-3.0 · (!) ALTA TENSÃO EM J1.4
README.md:
https://img.shields.io/badge/licen%C3%A7a-GPL--3.0-d6ac48
hardware/psh-jig1/psh-jig1.kicad_pcb:
REV 1.0 · github.com/aragonxpd154 · GPL-3.0
